greatscottgadgets/luna/(notices)

Notices in the files:
hardware/rev0/fpga_configuration.sch:
Copyright 2019-2021 Great Scott Gadgets
Licensed under the CERN-OHL-P v2
hardware/rev0/power_supplies.kicad_sch:
Copyright 2019-2023 Great Scott Gadgets
